FunTimesWithTheTA/Piezo-Pulse-Sensor/README.md

# Piezo-Pulse-Sensor
Pulse sensor made with a piezo element for detecting changes in pressure in finger with each heartbeat
