FunTimesWithTheTA/Piezo-Pulse-Sensor/Multimedia/Active Bandpass Filter.pdf

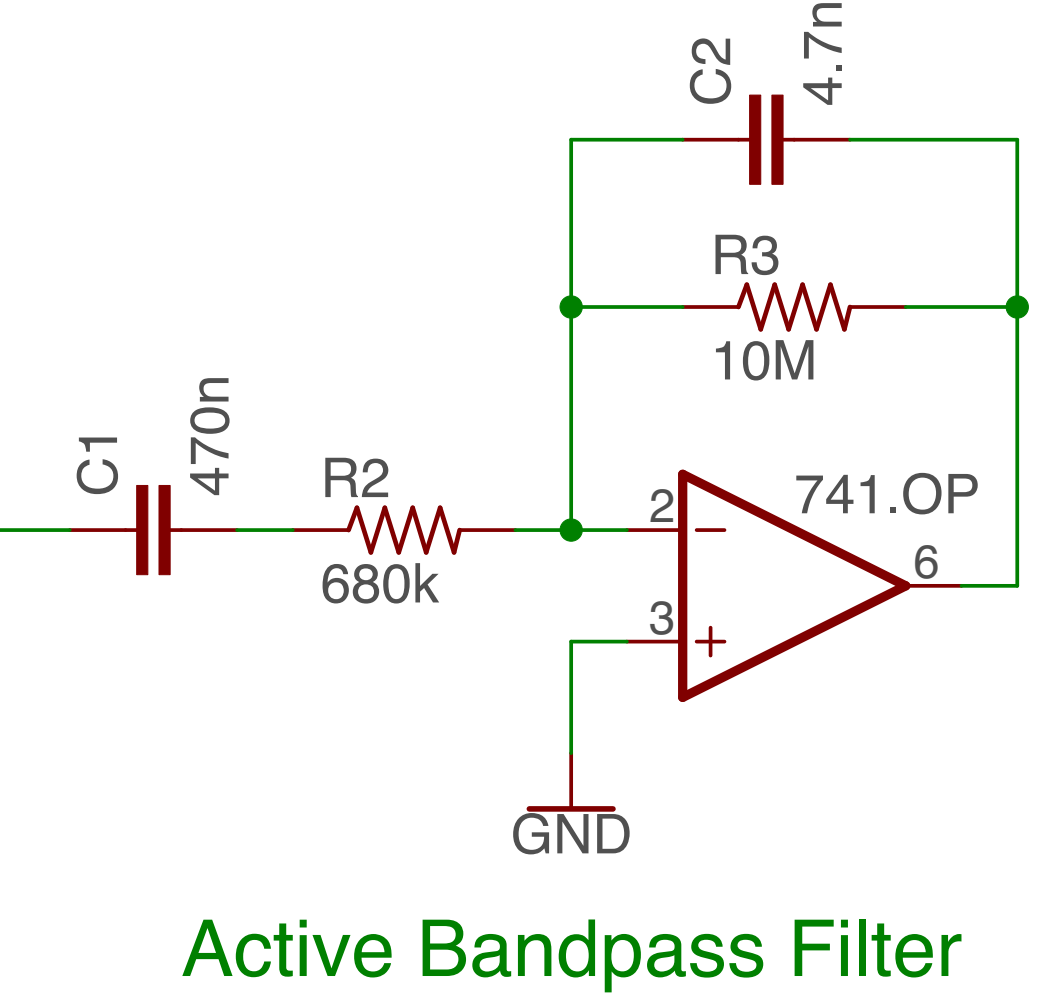
[picture p4: page 1]
