FunTimesWithTheTA/Piezo-Pulse-Sensor/Multimedia/Bypass Capacitors.pdf

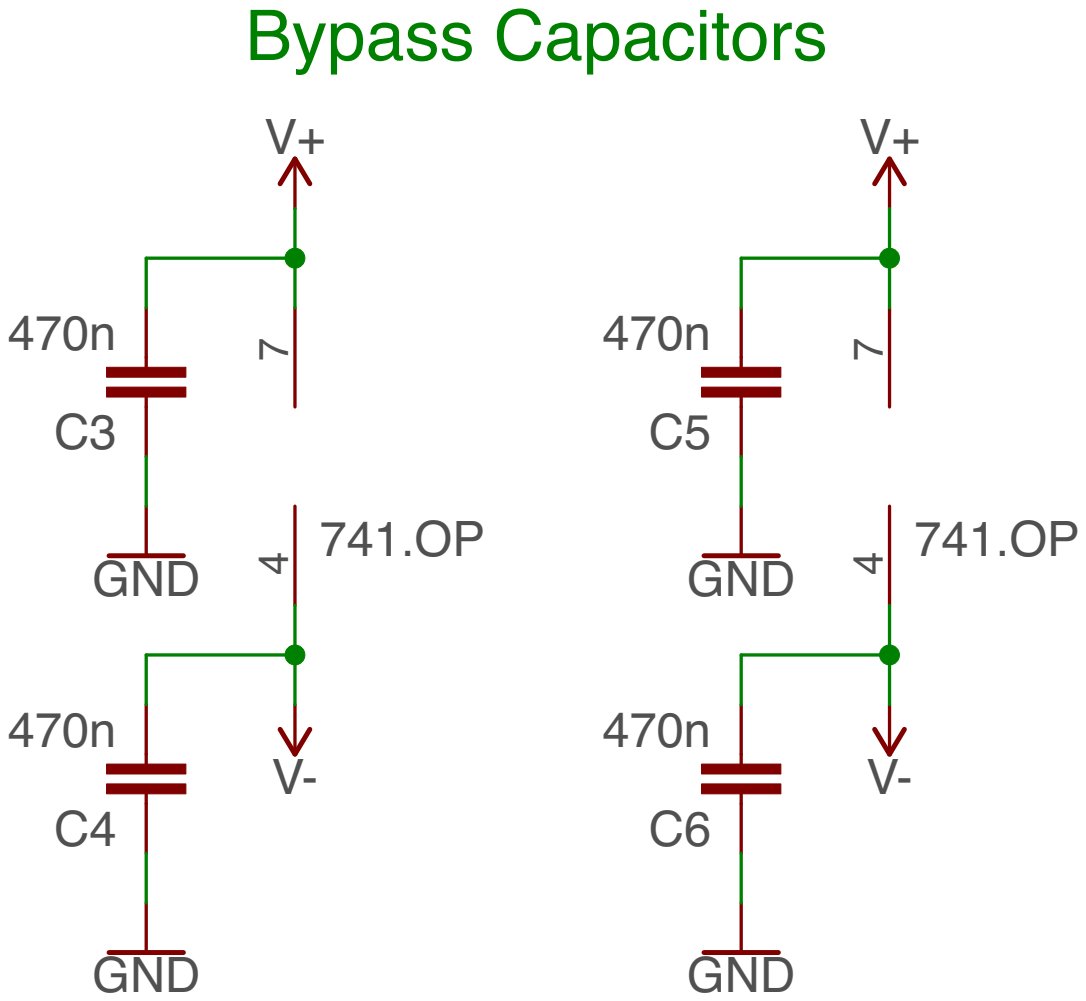
[picture p5: page 1]
