FunTimesWithTheTA/Piezo-Pulse-Sensor/Multimedia/Piezo Element and Buffer.pdf

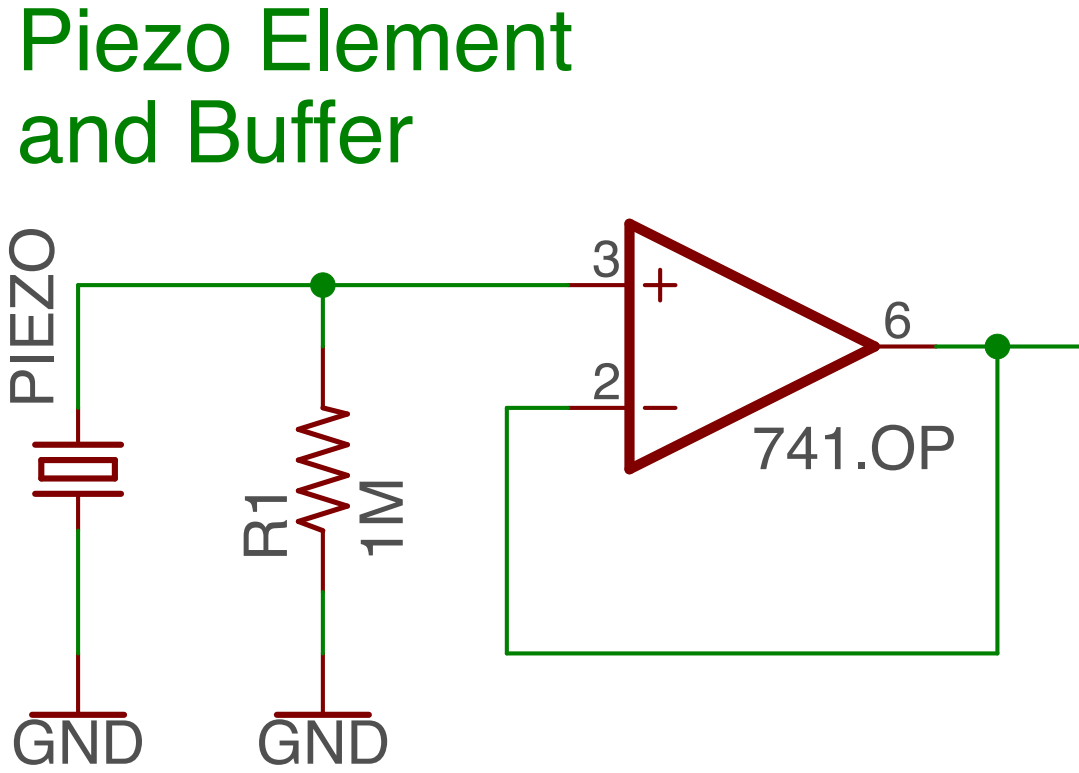
[picture p6: page 1]
