FunTimesWithTheTA/Piezo-Pulse-Sensor/Multimedia/PulsePIezo-sch.pdf

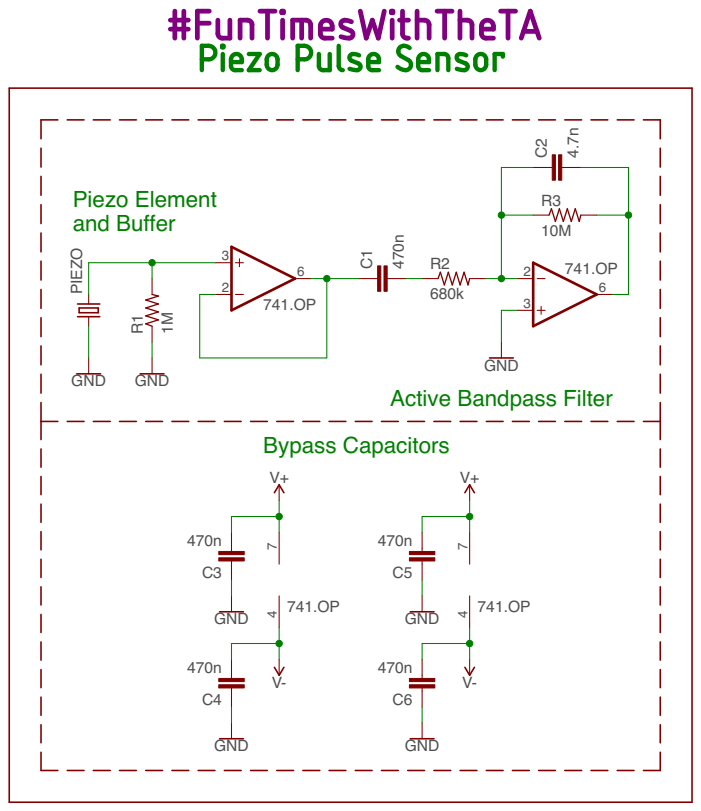
[picture p7: page 1]
