FunTimesWithTheTA/Piezo-Pulse-Sensor/Simulations/Piezo-Pulse-Sensor.asc

C1: cap; 470n
C2: cap; 4.7n
R1: res; 1Meg
R2: res; 680k
R3: res; 10Meg
U1: OP07
U2: OP07
V1: voltage; 2
V2: voltage; 7
V3: voltage; -7
V4: voltage; 7
V5: voltage; -7
V6: voltage; SINE(0 .5 60)
Named nets: 0
V6 is being connected to the bandpass filter
instead of the rest of the circuit to simulate 
the testing of the bandpass filter
.tran .1
