FunTimesWithTheTA/Piezo-Pulse-Sensor/Hardware/Piezo-Pulse-Sensor.sch

## EAGLE design Hardware/Piezo-Pulse-Sensor.sch (2018-06-23)

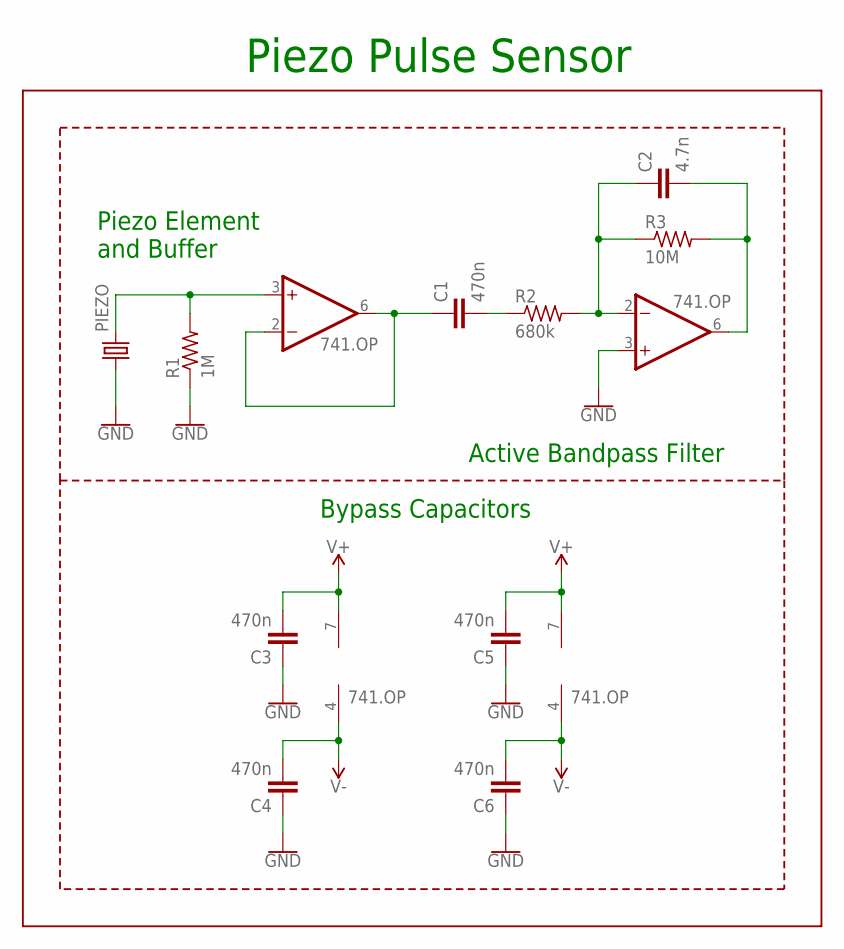
[picture p8: schematic Piezo-Pulse-Sensor.sch]

Parts:
C1, C3, C4, C5, C6: 470n; C0402
C2: 4.7n; C0402
OP1, OP2: 741.OP; DIL08
PIEZO: PIEZO-LEADED; VIA
R1: 1M; R0402
R2: 680k; R0402
R3: 10M; R0402

Connections:
GND: C3.1, C4.1, C5.1, C6.1, OP2.3 (+IN), PIEZO.1, R1.1
unnamed: OP1.3 (+IN), PIEZO.2, R1.2
unnamed: C1.1, OP1.2 (-IN), OP1.6 (OUT)
unnamed: C2.1, OP2.2 (-IN), R2.2, R3.1
unnamed: C1.2, R2.1
unnamed: C2.2, OP2.6 (OUT), R3.2
V+: C3.2, C5.2, OP1.7 (V+), OP2.7 (V+)
V-: C4.2, C6.2, OP1.4 (V-), OP2.4 (V-)

Notes on the sheet:
Bypass Capacitors
Active Bandpass Filter
Piezo Element and Buffer
Piezo Pulse Sensor
