FunTimesWithTheTA/Piezo-Pulse-Sensor/(commit log)

2018-06-23 updating after Fall 2017 semester
    [Piezo-Pulse-Sensor.sch]
2018-09-18 Updating the doc and simulation for Piezo-Pulse-Sensor
